Connaxio/espoir-io-one-hat/README.md

# IO One mikroShield

The IO One mikroShield is a mikroBUS<sup>TM</sup> add-on board that provides nine signal-voltage-ground (SVG) connectors, a temperature & humidity sensor, and a Digilent Pmod<sup>TM</sup> Compatible I<sup>2</sup>C connector.

Read all the details on [Connaxio's official Wiki](https://docs.connaxio.com/io_one_mikroshield/)
