Connaxio/espoir-io-one-hat/(commit log)

2022-05-07 New mikroBUS compatible version with 100 mils headers and PMOD type 6 (I2C) header. DRC pass. Still missing ambient light sensor. Add mikroBUS and PMOD standards
    [espoir_io_one_hat.kicad_pcb, espoir_io_one_hat.kicad_sch]
2022-05-07 Add light sensor. DRC pass.
    [espoir_io_one_hat.kicad_pcb, espoir_io_one_hat.kicad_sch]
2022-05-09 Add OSHW logo. Rename files with new project name. DRC pass.
    [io_one_mikroshield.kicad_pcb, io_one_mikroshield.kicad_sch]
2022-05-12 Silkscreen fixes
    [io_one_mikroshield.kicad_pcb]
2022-05-12 Move extra IO header oustide mikroBUS zone re-fix silkscreen
    [io_one_mikroshield.kicad_pcb]
2022-05-13 Add OSHWA UID
    [io_one_mikroshield.kicad_pcb]
2022-05-26 Remove light sensor
    [io_one_mikroshield.kicad_pcb, io_one_mikroshield.kicad_sch]
2022-05-28 Group extension-dependent inputs at the extremity of the 3x9 connector (more logical) Make inputs-only headers' capacitors' trace easy to cut if more bandwidth is required.
    [io_one_mikroshield.kicad_pcb, io_one_mikroshield.kicad_sch]
2022-05-28 Rename Ax and Dx for Ix and IOx on the overlay
    [io_one_mikroshield.kicad_pcb]
2022-05-28 Fix 1-wire uart RX/TX logic
    [io_one_mikroshield.kicad_pcb, io_one_mikroshield.kicad_sch]
2022-05-29 Fix Pmod naming scheme for licensing Add RoHS logo
    [io_one_mikroshield.kicad_pcb]
2022-05-30 Fix schematic pin names to match PCB Fix schematic I2C header name
    [io_one_mikroshield.kicad_pcb, io_one_mikroshield.kicad_sch]
2022-06-17 Fix license and input traces overlay
    [io_one_mikroshield.kicad_pcb]
2022-09-19 Add NMOS to PMOS switch control to remove dependency on open drain outputs configurations, and add default level (off)
    [io_one_mikroshield.kicad_pcb, io_one_mikroshield.kicad_sch]
2022-09-20 Fix pull-down location and value
    [io_one_mikroshield.kicad_pcb, io_one_mikroshield.kicad_sch]
2022-09-20 Add capacitors to inputs and input/ouput pins to counter possible voltages spikes caused by cable inductance
    [io_one_mikroshield.kicad_pcb, io_one_mikroshield.kicad_sch]
2022-10-13 Fix paste Fix grid origin Add NPN transistors to control the PMOS power-enabling transistors
    [io_one_mikroshield.kicad_pcb]
2022-11-02 Fix BOM list and update 1k resistors to 1.54k to reduce different parts count
    [io_one_mikroshield.kicad_pcb, io_one_mikroshield.kicad_sch]
