Connaxio/espoir-io-one-hat/(notices)

Notices in the files:
pcb/espoir_io_one_hat.kicad_pcb:
Licensed under
CERN-OHL-W v2
